Calavoow/fiber-tap/README.md

fiber-tap
=========

Tapping a fiber-optic cable using cheap hardware

Setup
-----
After cloning the repo, run ``git submodule init`` and ``git submodule update`` to download dependencies.
You can then add the libraries in ``lib/`` to the Arduino library through the usual method.
