Calavoow/fiber-tap/transmitter/schematic/readme.md

#Schema
The schema of the Arduino connections.
It doesn't show the fiber optic cable, which is connected to the LED and the photoresistor.
Schematic Layout
