Calavoow/fiber-tap/doc/bending_sharpened.png

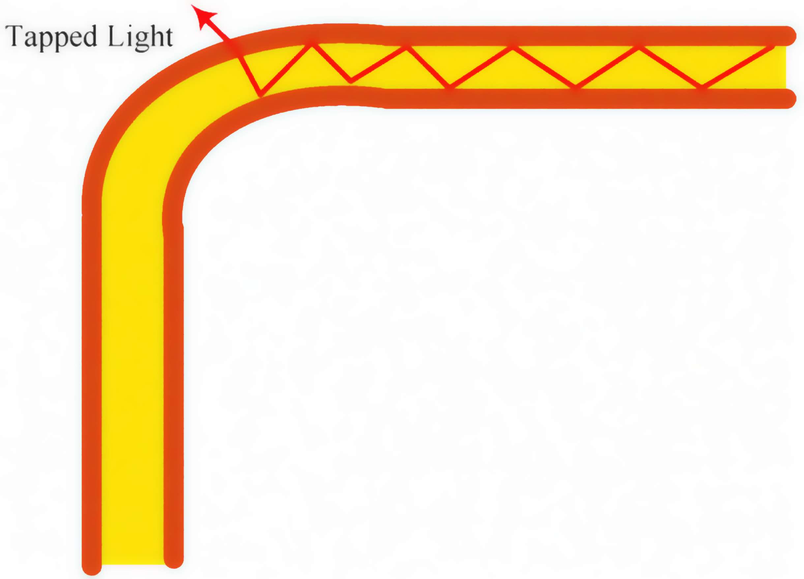
doc/bending_sharpened.png
