Calavoow/fiber-tap/doc/fiber_tap_graphic_resized_cleaned.png

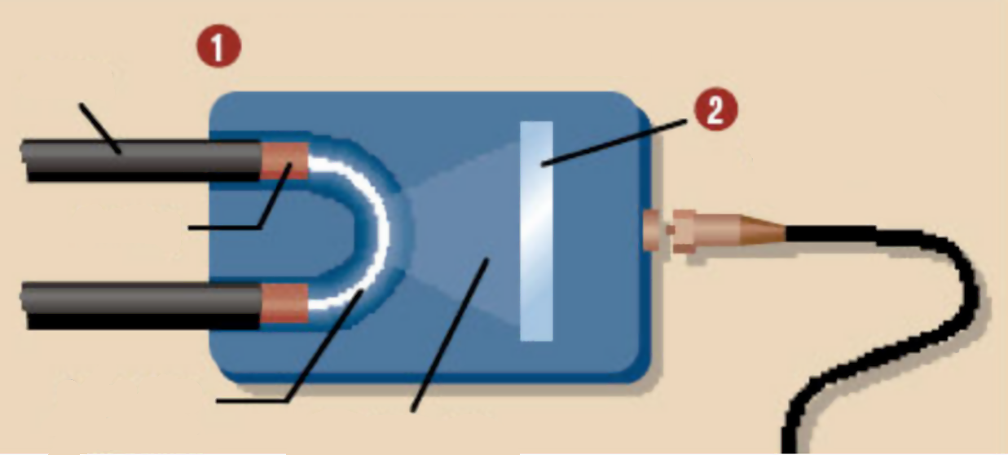
doc/fiber_tap_graphic_resized_cleaned.png
