Calavoow/fiber-tap/doc/microbend.png

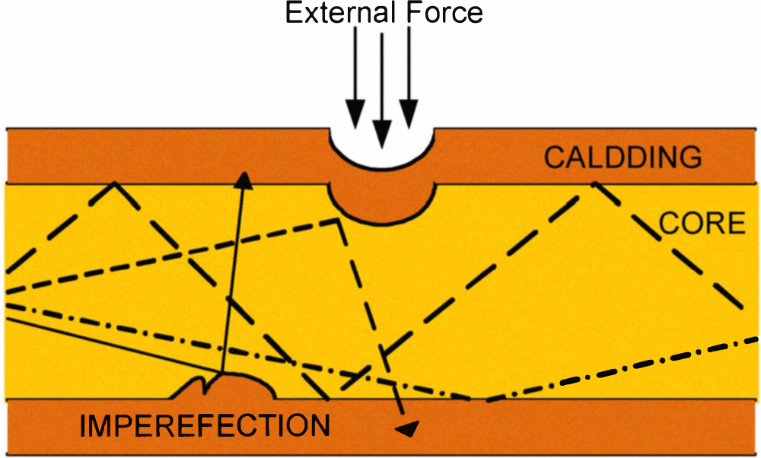
doc/microbend.png
