Calavoow/fiber-tap/(list of files, drawings)

Other design files:
transmitter/schematic/transmitter.fzz
