Calavoow/fiber-tap/(commit log)

2014-02-15 Added Timer library
2014-02-15 Implemented transmitter with Timer
2014-02-15 Added schematic for the transmitter test board.
    [transmitter.fzz]
2014-02-18 Updated schematic
    [transmitter.fzz]
2014-02-25 Added schematic readme.
2014-05-08 Working transmission over fiber cable
2014-06-02 Added more about the proof of concept.
    Also cleaned up code.
    [transmitter.fzz]
2014-06-28 Updated resistor value
2015-01-10 Set synchronisation to 0xCBFEBABE
    First transistion is 0->1 so that synchronisation from no signal to a
    signal is correct.
    [receiver.ino, transmitter.ino]
2015-01-21 Replaced micro with macro bend device.
    Added conclusion.
    Split the shopping list in two, including an optional part.
